evortriede/AsyncLWCMonitor/hardware/LWCMonitorBOM.md

# AsyncLWCMonitor Bill of Materials

- Obtained specifically for this project
  - Heltec ESP32 LoRa V2 microcontroller [ESP32](https://smile.amazon.com/gp/product/B07HJ49VN8)
  - Buzzer [Buzzer](https://smile.amazon.com/gp/product/B01FVZQ6F6)
  - RGB LED [LED](https://smile.amazon.com/gp/product/B077XGF3YR)
  - Switch [Switch](https://smile.amazon.com/gp/product/B07RMDNDK3)
  - Battery [Battery](https://smile.amazon.com/gp/product/B0867KDMY7)
- Various materials on-hand at shop
  - Strip board (cut down to size) [Strip Board](https://smile.amazon.com/gp/product/B088GSJM7G)
  - Wire
  - Resistors
  - Solder
  - Dupont Connector Kit [Dupont kit](https://smile.amazon.com/gp/product/B07JG8HVLG)
    - Dupont Connectors
    - Sockets
    - Headers
