evortriede/AsyncLWCMonitor/(list of files, drawings)

Other design files:
hardware/LWCMonitorV2.dsn
