evortriede/AsyncLWCMonitor/(commit log)

2023-01-30 Added pump value to main page
2023-02-08 Various refinements
    Fixed race condition where HandleAsyncStatusUpdate was called from two threads at the same time.
    Added voice to lwcmon.html
    Modified hotspot search to favor configured SSID first.
    [AsyncLWCMonitor.h, AsyncLWCMonitor.ino, WiFiSetup.ino]
2023-02-10 Documentation and mDNS
    [LWCMonitorV2.dsn]
2024-07-21 New Arduino IDE on new computer
    IDE updated libraries requiring changes to ledc API
    Added build and .idea to .gitignore
2025-09-24 New Heltec and ESP32 libs
    Many changes to comply with changes to Heltec and ESP32 libraries. Also added a logo to the web tab.
